tp-neal/stm32-self-balancing-robot/models/2-Wheel+Self-balancing+Robot.stl

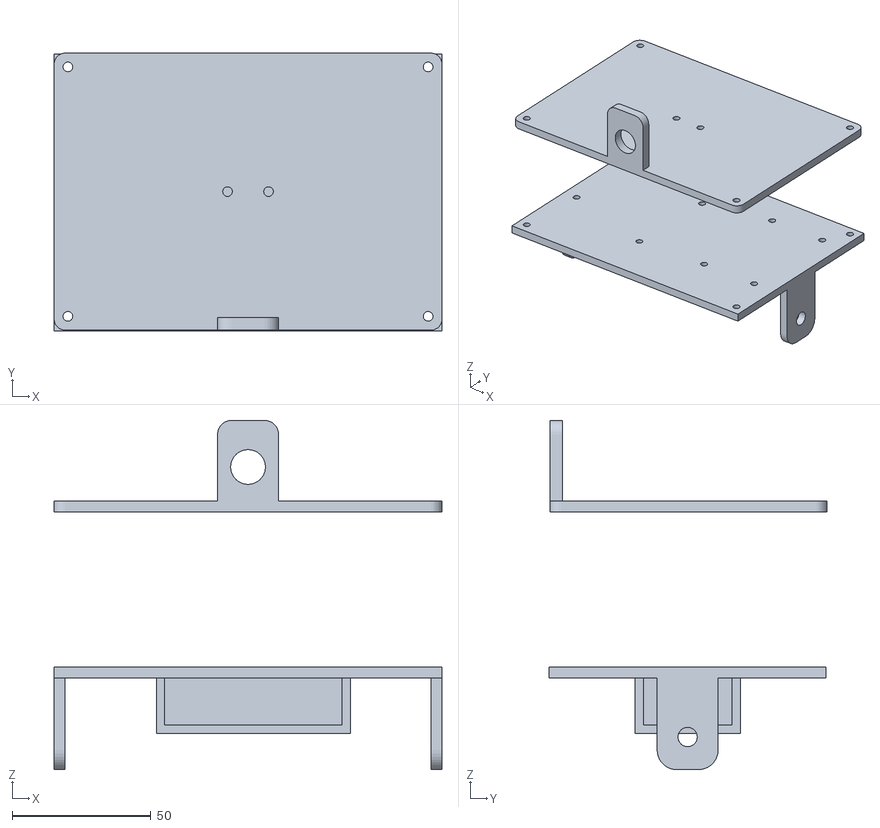
[picture p3: CAD file, 2025-08-22]
models/2-Wheel+Self-balancing+Robot.stl
140.0 x 100.3 x 126.0
