tp-neal/stm32-self-balancing-robot/Core/Src/main.c

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
/* Includes ------------------------------------------------------------------*/
#include "main.h"
#include "cmsis_os.h"

/* USER CODE BEGIN Includes */
#include <stdio.h>
#include <stdlib.h>
#include <string.h>
#include <math.h>
#include <inttypes.h>
#include "queue.h"
/* USER CODE END Includes */

/* USER CODE BEGIN PTD */
typedef struct {
	float accel_pitch;	// holds the accelerometer's derrived pitch
	float gyro_pitch;	// holds the gyroscope's integrated pitch
	float comp_pitch;	// holds the complementary filter's computed pitch
} Pitch_t;

typedef struct {
	TIM_HandleTypeDef *htim;	// pointer to the motor's timer handler struct
	uint8_t channels[2];		// holds both motor's pwm channels
} Motor_t;

typedef enum {
	COMPLETE_SUCCESS = 0,
	IMU_CONFIG_FAILED_WAKE = -100,
	IMU_CONFIG_FAILED_PWR_MGMT_2_READ = -101,
	IMU_CONFIG_FAILED_PWR_MGMT_2_WRITE = -102,
	IMU_CONFIG_FAILED_INTERRUPT_ENABLE = -103,
} Error_code_t;
/* USER CODE END PTD */

/* USER CODE BEGIN PD */
#define I2C_TRIALS 5						// number of attempts to check device readiness
#define MPU6050_Addr (0x68 << 1)			// address of the mpu6050 on the I2C line
#define MPU6050_WAKE 0x00					// mask used to wake the mpu6050 from sleep
#define PWR_MGMT_1_Addr 0x6B				// address of the first power management register of the mpu6050
#define PWR_MGMT_2_Addr 0x6C				// address of the first power management register of the mpu6050
#define INT_ENABLE_Addr 0x38				// address for imu registers that allows enabling of the interrupt pin
#define STANDBY_ACCEL_Y_AXIS (1UL << 4) 	// mask for accelerometer y-axis standby mode bit
#define STANDBY_GYRO_X_AXIS (1UL << 2) 		// mask for gyroscope x-axis standby mode bit
#define STANDBY_GYRO_Z_AXIS (1UL << 0)  	// mask for gyroscope z-axis standby mode bit
#define MPU6050_DATA_READY_Enable 0x01		// ???
#define ACCEL_XOUT_H_Addr 0x3B				// address of the high byte for accelerometer x-axis output
#define ACCEL_XOUT_L_Addr 0x3C				// address of the low byte for accelerometer x-axis output
#define ACCEL_ZOUT_H_Addr 0x3F				// address of the high byte for accelerometer z-axis output
#define ACCEL_ZOUT_L_Addr 0x40				// address of the low byte for accelerometer z-axis output
#define GYRO_YOUT_H_Addr 0x45				// address of the high byte for gyroscope y-axis output
#define GYRO_YOUT_L_Addr 0x46				// address of the high byte for gyroscope y-axis output
#define ACCEL_SENSITIVITY 16384				// sensitivity value used to convert raw IMU data into units
#define GYRO_SENSITIVITY 131				// sensitivity value used to convert raw IMU data into units
#define COMP_FILTER_COEFF 0.99				// coefficient the complementary filter uses to weight its measurment

#define IMU_CALIBRATION_PRE_MSG_DELAY 1000	// delay before calibration message allowing user to get robot into place
#define IMU_CALIBRATION_POST_MSG_DELAY 1000	// delay after calibration message allowing user to read the calibration value

#define PRINT_IMU_CONFIG_ERRORS 1			// prints IMU configuration errors when set to 1
#define PRINT_IMU_CALIBRATION_ERRORS 1		// prints IMU calibration errors when set to 1
#define PRINT_I2C_ERRORS 0					// prints I2C communication info when set to 1
#define PRINT_PID_ERROR 0					// prints PID errors when set to 1

#define PRINT_COMPUTED_PITCHES 0			// prints computed complementary pitches when set to 1
#define IMU_CONFIG_NUM_SAMPLES 100			// number of samples that are to be used to zero out accelerometer pitch
#define NUM_IMU_READ_ATTEMPTS_PER_READ 1	// when our attempt to read from the imu fails, this is the amount of retries before giving up

#define AUTO_RELOAD_REGISTER 4000			// auto reload register value for the pwm channels
#define TICKS_PER_SECOND 1000				// number of clock ticks per second

#define I2C_TIMEOUT_MS 10 					// milliseconds to wait per attempt
#define UART_TIMEOUT_MS HAL_MAX_DELAY 		// milliseconds to wait per uart transmit

#define UART_INTERRUPT_CHAR_SENDBACK_TIMEOUT 10

#define COEFFICIENT_PERCISION 3

#define D_OUT_SCALER 100
/* USER CODE END PD */

/* USER CODE BEGIN PM */
#define FATAL_ERROR(code) do { \
    g_error_file = __FILE__; \
    g_error_line = __LINE__; \
    g_error_code = (code);   \
    Error_Handler();         \
} while(0)
/* USER CODE END PM */

I2C_HandleTypeDef hi2c1;

TIM_HandleTypeDef htim2;
TIM_HandleTypeDef htim3;

UART_HandleTypeDef huart2;

/* Definitions for defaultTask */
osThreadId_t defaultTaskHandle;
const osThreadAttr_t defaultTask_attributes = { .name = "defaultTask", .stack_size = 128 * 4,
		.priority = (osPriority_t) osPriorityNormal, };
/* Definitions for imuReadTask */
osThreadId_t imuReadTaskHandle;
const osThreadAttr_t imuReadTask_attributes = { .name = "imuReadTask", .stack_size = 512 * 4,
		.priority = (osPriority_t) osPriorityHigh, };
/* Definitions for balanceTask */
osThreadId_t balanceTaskHandle;
const osThreadAttr_t balanceTask_attributes = { .name = "balanceTask", .stack_size = 512 * 4,
		.priority = (osPriority_t) osPriorityHigh, };
/* Definitions for coefficientPoll */
osThreadId_t coefficientPollHandle;
const osThreadAttr_t coefficientPoll_attributes = { .name = "coefficientPoll",
		.stack_size = 512 * 4, .priority = (osPriority_t) osPriorityNormal, };
/* Definitions for uartRxQueue */
osMessageQueueId_t uartRxQueueHandle;
const osMessageQueueAttr_t uartRxQueue_attributes = { .name = "uartRxQueue" };
/* Definitions for imuDataMutex */
osMutexId_t imuDataMutexHandle;
const osMutexAttr_t imuDataMutex_attributes = { .name = "imuDataMutex" };
/* Definitions for imuDataReadySem */
osSemaphoreId_t imuDataReadySemHandle;
const osSemaphoreAttr_t imuDataReadySem_attributes = { .name = "imuDataReadySem" };
/* Definitions for uartDataReady */
osSemaphoreId_t uartDataReadyHandle;
const osSemaphoreAttr_t uartDataReady_attributes = { .name = "uartDataReady" };
/* USER CODE BEGIN PV */
volatile const char *g_error_file = NULL;
volatile int g_error_line = 0;
volatile int g_error_code = 0;

volatile Pitch_t pitches = { .accel_pitch = 0.0, .gyro_pitch = 0.0, .comp_pitch = 0.0 };
float initial_accel_pitch_offset_deg = 0.0f;

Motor_t left_motor;
Motor_t right_motor;

uint8_t uart_recieved_byte;
uint16_t uart_recieved_byte_size = sizeof(uart_recieved_byte);

uint8_t uart_rx_buffer_index = 0;
char uart_rx_buffer[6]; // [0] type | [1:3] value | [4] carriage return | [5] null-terminator
uint16_t uart_rx_buffer_size = sizeof(uart_rx_buffer) / sizeof(uart_rx_buffer[0]);

volatile float kp = 0.20;
volatile float ki = 1.00;
volatile float kd = 0.30;
/* USER CODE END PV */

void SystemClock_Config(void);
static void MX_GPIO_Init(void);
static void MX_USART2_UART_Init(void);
static void MX_I2C1_Init(void);
static void MX_TIM2_Init(void);
static void MX_TIM3_Init(void);
void StartDefaultTask(void *argument);
void startIMUReadTask(void *argument);
void selfBalanceTask(void *argument);
void coefficientPollingTask(void *argument);

/* USER CODE BEGIN PFP */
// --- IMU Functions ---
static void configure_imu_power(void);
static void calibrate_imu(void);
static void process_imu_data(const uint8_t *data_buffer, Pitch_t *pitch_buffer, float dt);
static void update_global_imu_data(Pitch_t *pitch_buffer);
static void print_i2c_read_error(void);

// --- Motor Driver Functions ---
static void start_pwm_channels(void);
static void set_motor_duty_cycle(Motor_t *motor, float speed_control);

// --- Helper Functions ---
static void uart_print(char *buffer);
static void resetI2C(void);
char* HAL_StatusToString(HAL_StatusTypeDef status);
char* HAL_I2C_ErrorToString(I2C_HandleTypeDef* i2c_handle);
/* USER CODE END PFP */

/**
 * @brief  The application entry point.
 * @retval int
 */
int main(void) {

	/* MCU Configuration--------------------------------------------------------*/

	/* Reset of all peripherals, Initializes the Flash interface and the Systick. */
	HAL_Init();

	/* Configure the system clock */
	SystemClock_Config();

	/* Initialize all configured peripherals */
	MX_GPIO_Init();
	MX_USART2_UART_Init();
	MX_I2C1_Init();
	MX_TIM2_Init();
	MX_TIM3_Init();
	/* USER CODE BEGIN 2 */
	char nl[] = "\r\n";
	uart_print(nl); // quick newline print to seperate console logs

	// Configure the Motors
	left_motor.htim = &htim2;
	left_motor.channels[0] = TIM_CHANNEL_1;
	left_motor.channels[1] = TIM_CHANNEL_2;
	right_motor.htim = &htim3;
	right_motor.channels[0] = TIM_CHANNEL_3;
	right_motor.channels[1] = TIM_CHANNEL_4;

	HAL_GPIO_WritePin(DRV8833_SLEEP_GPIO_Port, DRV8833_SLEEP_Pin, GPIO_PIN_RESET); // make sure motor is in low power (steadystate)
	start_pwm_channels();
	HAL_GPIO_WritePin(DRV8833_SLEEP_GPIO_Port, DRV8833_SLEEP_Pin, GPIO_PIN_SET); // take motor driver out of low power

	// Prepare imu
	configure_imu_power(); // configure the imu for i2c communication
	calibrate_imu(); // zero out the accelerometer's pitch calculation

	// Start listening for user's input to tweak variables during runtime
	if (HAL_UART_Receive_IT(&huart2, &uart_recieved_byte, 1) != HAL_OK) {
		char error_buffer[] = "[WARNING]: UART interrupt service is not functioning\r\n";
		uart_print(error_buffer);
	}
	/* USER CODE END 2 */

	/* Init scheduler */
	osKernelInitialize();
	/* Create the mutex(es) */
	/* creation of imuDataMutex */
	imuDataMutexHandle = osMutexNew(&imuDataMutex_attributes);

	/* USER CODE BEGIN RTOS_MUTEX */
	/* add mutexes, ... */
	/* USER CODE END RTOS_MUTEX */

	/* Create the semaphores(s) */
	/* creation of imuDataReadySem */
	imuDataReadySemHandle = osSemaphoreNew(1, 0, &imuDataReadySem_attributes);

	/* creation of uartDataReady */
	uartDataReadyHandle = osSemaphoreNew(1, 0, &uartDataReady_attributes);

	/* USER CODE BEGIN RTOS_SEMAPHORES */
	/* add semaphores, ... */
	/* USER CODE END RTOS_SEMAPHORES */

	/* USER CODE BEGIN RTOS_TIMERS */
	/* start timers, add new ones, ... */
	/* USER CODE END RTOS_TIMERS */

	/* Create the queue(s) */
	/* creation of uartRxQueue */
	uartRxQueueHandle = osMessageQueueNew(8, sizeof(uint8_t), &uartRxQueue_attributes);

	/* USER CODE BEGIN RTOS_QUEUES */
	/* add queues, ... */
	/* USER CODE END RTOS_QUEUES */

	/* Create the thread(s) */
	/* creation of defaultTask */
	defaultTaskHandle = osThreadNew(StartDefaultTask, NULL, &defaultTask_attributes);

	/* creation of imuReadTask */
	imuReadTaskHandle = osThreadNew(startIMUReadTask, NULL, &imuReadTask_attributes);

	/* creation of balanceTask */
	balanceTaskHandle = osThreadNew(selfBalanceTask, NULL, &balanceTask_attributes);

	/* creation of coefficientPoll */
	coefficientPollHandle = osThreadNew(coefficientPollingTask, NULL, &coefficientPoll_attributes);

	/* USER CODE BEGIN RTOS_THREADS */
	/* add threads, ... */
	/* USER CODE END RTOS_THREADS */

	/* USER CODE BEGIN RTOS_EVENTS */
	/* add events, ... */
	/* USER CODE END RTOS_EVENTS */

	/* Start scheduler */
	osKernelStart();

	/* We should never get here as control is now taken by the scheduler */

	/* Infinite loop */
	/* USER CODE BEGIN WHILE */
	while (1) {
		/* USER CODE END WHILE */

		/* USER CODE BEGIN 3 */
	}
	/* USER CODE END 3 */
}

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
/* USER CODE BEGIN 4 */
/*===============================================================================================*/
// IMU Functions
/*===============================================================================================*/

/**
 * @brief Prepares I2C communication and configures the MPU6050 to begin comms.
 */
static void configure_imu_power(void) {
	// Wait for the IMU to be ready
	while (HAL_I2C_IsDeviceReady(&hi2c1, MPU6050_Addr, I2C_TRIALS, I2C_TIMEOUT_MS) != HAL_OK)
		;
	// we cannot proceed until this device is ready

	uint8_t data_byte;

	// Wake up the MPU6050 from sleep mode
	data_byte = MPU6050_WAKE; // we will clear the sleep bit
	while (HAL_I2C_Mem_Write(&hi2c1, MPU6050_Addr, PWR_MGMT_1_Addr, I2C_MEMADD_SIZE_8BIT,
			&data_byte, 1, I2C_TIMEOUT_MS) != HAL_OK) {
		FATAL_ERROR(IMU_CONFIG_FAILED_WAKE);
	}

	// Wait a few ms for the device to stabilize after power changes
	HAL_Delay(10);

	// Set unused IMU peripherals into standby mode
	// Read the current register value to not overwrite other settings
	while (HAL_I2C_Mem_Read(&hi2c1, MPU6050_Addr, PWR_MGMT_2_Addr, I2C_MEMADD_SIZE_8BIT, &data_byte,
			1, I2C_TIMEOUT_MS) != HAL_OK) {
		FATAL_ERROR(IMU_CONFIG_FAILED_PWR_MGMT_2_READ);
	}

	data_byte |= (STANDBY_ACCEL_Y_AXIS | STANDBY_GYRO_X_AXIS | STANDBY_GYRO_Z_AXIS);

	// Write the modified value back to the register
	while (HAL_I2C_Mem_Write(&hi2c1, MPU6050_Addr, PWR_MGMT_2_Addr, I2C_MEMADD_SIZE_8BIT,
			&data_byte, 1,
			I2C_TIMEOUT_MS) != HAL_OK) {
		FATAL_ERROR(IMU_CONFIG_FAILED_PWR_MGMT_2_WRITE);
	}

	// Enable the Data Ready Interrupt on the MPU6050
	data_byte = MPU6050_DATA_READY_Enable; // sets the DATA_RDY_EN bit
	while (HAL_I2C_Mem_Write(&hi2c1, MPU6050_Addr, INT_ENABLE_Addr, I2C_MEMADD_SIZE_8BIT,
			&data_byte, 1,
			I2C_TIMEOUT_MS) != HAL_OK) {
		FATAL_ERROR(IMU_CONFIG_FAILED_INTERRUPT_ENABLE);
	}
}

/**
 * @brief Establishes a baseline for the IMU to disregard initial pitch.
 */
static void calibrate_imu(void) {
	uint8_t rx_buffer[14];
	float sum_accel_x_g_force = 0;
	float sum_accel_z_g_force = 0;

	char calibration_warning[] = "Calibrating... Keep robot Level!\r\n";
	uart_print(calibration_warning);
	HAL_Delay(IMU_CALIBRATION_PRE_MSG_DELAY);

	// Make sure MPU is ready before starting
	while (HAL_I2C_IsDeviceReady(&hi2c1, MPU6050_Addr, I2C_TRIALS, I2C_TIMEOUT_MS) != HAL_OK) {
		// wait for device to be ready
	}

	// Perform a number of reads to get a baseline measurment for zeroing out the accelerometer pitch
	HAL_StatusTypeDef status;
	int attempts;
	for (int i = 0; i < IMU_CONFIG_NUM_SAMPLES; i++) {
		// We need to make sure we get a valid read for every sample to ensure our zeroing is accurate
		attempts = 0;
		while ((status = HAL_I2C_Mem_Read(&hi2c1, MPU6050_Addr, ACCEL_XOUT_H_Addr, I2C_MEMADD_SIZE_8BIT,
				rx_buffer, 14, I2C_TIMEOUT_MS)) != HAL_OK && attempts < NUM_IMU_READ_ATTEMPTS_PER_READ) {
			// We will attempt to read the IMU, and if it doesnt give us a valid read after x, attemps reset the I2C bus and try again
			if (PRINT_IMU_CALIBRATION_ERRORS) {
				char error_buffer[128];
				sprintf(error_buffer, "Failed to read from IMU during calibration [%s]\r\n", HAL_StatusToString(status));
				uart_print(error_buffer);

				if (status == HAL_ERROR) {
					// If the status is an I2C error, print info
					uart_print(HAL_I2C_ErrorToString(&hi2c1));
				}
			}

			attempts++;
			if (attempts >= NUM_IMU_READ_ATTEMPTS_PER_READ) {
				resetI2C();
				attempts = 0;
			}

		}

		// Since read was successful, decode it
		int16_t raw_accel_x = (int16_t) (rx_buffer[0] << 8 | rx_buffer[1]);
		int16_t raw_accel_z = (int16_t) (rx_buffer[4] << 8 | rx_buffer[5]);

		float adjusted_accel_x = ((float) raw_accel_x / ACCEL_SENSITIVITY);
		float adjusted_accel_z = ((float) raw_accel_z / ACCEL_SENSITIVITY);

		sum_accel_x_g_force += adjusted_accel_x;
		sum_accel_z_g_force += adjusted_accel_z;
	}

	// Calculate the average offset
	float avg_accel_x_g_force = sum_accel_x_g_force / IMU_CONFIG_NUM_SAMPLES;
	float avg_accel_z_g_force = sum_accel_z_g_force / IMU_CONFIG_NUM_SAMPLES;

	// Calculate the initial angle from the averages and store it
	initial_accel_pitch_offset_deg = atan2(avg_accel_x_g_force, avg_accel_z_g_force) * 180.0 / M_PI;

	char calibration_complete[128];
	sprintf(calibration_complete, "Calibration complete! Offset Angle: %f\r\n",
			initial_accel_pitch_offset_deg);
	uart_print(calibration_complete);

	HAL_Delay(IMU_CALIBRATION_POST_MSG_DELAY);
}

/**
 * @brief Converts raw IMU data into the process pitch values for the accelerometer, gyroscope, and complementary filter
 * @param const uint8_t* data_buffer - Buffer that contains the raw data read from the I2C channel
 * @param Pitch_t* pitch_buffer - Buffer to store the computed pitches in for return
 * @param float dt - Change in time between the last data read and the current
 */
static void process_imu_data(const uint8_t *data_buffer, Pitch_t *pitch_buffer, float dt) {
	// Combine high and low bytes
	int16_t raw_accel_x = (int16_t) (data_buffer[0] << 8 | data_buffer[1]);
	int16_t raw_accel_z = (int16_t) (data_buffer[4] << 8 | data_buffer[5]);
	int16_t raw_gyro_y = (int16_t) (data_buffer[10] << 8 | data_buffer[11]);

	float accel_x = ((float) raw_accel_x / ACCEL_SENSITIVITY);
	float accel_z = ((float) raw_accel_z / ACCEL_SENSITIVITY);
	float gyro_y = ((float) raw_gyro_y / GYRO_SENSITIVITY);

	float absolute_accel_pitch_deg = atan2(accel_x, accel_z) * 180.0 / M_PI;
	float relative_accel_pitch_deg = absolute_accel_pitch_deg - initial_accel_pitch_offset_deg;

	pitch_buffer->accel_pitch = relative_accel_pitch_deg;
	pitch_buffer->gyro_pitch = (gyro_y * dt);
	osMutexAcquire(imuDataMutexHandle, osWaitForever);
	pitch_buffer->comp_pitch = COMP_FILTER_COEFF * (pitches.comp_pitch - pitch_buffer->gyro_pitch)
			+ (1.0 - COMP_FILTER_COEFF) * pitch_buffer->accel_pitch;
	osMutexRelease(imuDataMutexHandle);
}

/**
 * @brief Updates the global references of the objects transform and pitches
 * @param Pitch_t* pitch_buffer - Buffer that contains the computed pitches to write to the gloabal reference
 */
static void update_global_imu_data(Pitch_t *pitch_buffer) {
	osMutexAcquire(imuDataMutexHandle, osWaitForever);

	// Update estimated pitch information
	pitches.accel_pitch = pitch_buffer->accel_pitch;
	pitches.gyro_pitch -= pitch_buffer->gyro_pitch;
	pitches.comp_pitch = pitch_buffer->comp_pitch;
	osMutexRelease(imuDataMutexHandle);

	if (PRINT_COMPUTED_PITCHES) {
		char uartBuffer[128];
		sprintf(uartBuffer, "accel-pitch: %f\tgyro-pitch: %f\tcomp-pitch: %f\r\n",
				pitches.accel_pitch, pitches.gyro_pitch, pitches.comp_pitch);
		uart_print(uartBuffer);
	}
}

/**
 * @brief Prints a descriptive message to UART based on the I2C error code
 */
static void print_i2c_read_error(void) {
	char errorBuffer[128];
	uint32_t i2c_error = HAL_I2C_GetError(&hi2c1);

	if (i2c_error & HAL_I2C_ERROR_BERR) {
		sprintf(errorBuffer,
				"MPU6050 Read Error: Bus Error (BERR). Check wiring/signal integrity.\r\n");
	} else if (i2c_error & HAL_I2C_ERROR_ARLO) {
		sprintf(errorBuffer,
				"MPU6050 Read Error: Arbitration Lost (ARLO). Check for noise or other masters.\r\n");
	} else if (i2c_error & HAL_I2C_ERROR_AF) {
		sprintf(errorBuffer,
				"MPU6050 Read Error: Acknowledge Failure (AF/NACK). Sensor may be busy or disconnected.\r\n");
	} else if (i2c_error & HAL_I2C_ERROR_OVR) {
		sprintf(errorBuffer, "MPU6050 Read Error: Overrun/Underrun (OVR).\r\n");
	} else if (i2c_error & HAL_I2C_ERROR_TIMEOUT) {
		sprintf(errorBuffer, "MPU6050 Read Error: Timeout occurred. Check bus activity.\r\n");
	} else if (i2c_error & HAL_I2C_ERROR_DMA) {
		sprintf(errorBuffer, "MPU6050 Read Error: DMA transfer error.\r\n");
	} else {
		sprintf(errorBuffer, "MPU6050 Read Error: Unknown I2C Error. Code: 0x%lX\r\n", i2c_error);
	}
	uart_print(errorBuffer);
}

/*===============================================================================================*/
// Motor Driver Functions
/*===============================================================================================*/

/**
 * @brief Begins the timer pwm channels and puts them in a stopped position
 */
static void start_pwm_channels(void) {
	// Begin the PWM
	HAL_TIM_PWM_Start(&htim2, TIM_CHANNEL_1);
	HAL_TIM_PWM_Start(&htim2, TIM_CHANNEL_2);
	HAL_TIM_PWM_Start(&htim3, TIM_CHANNEL_3);
	HAL_TIM_PWM_Start(&htim3, TIM_CHANNEL_4);

	// Default motors with no movement
	__HAL_TIM_SET_COMPARE(&htim2, TIM_CHANNEL_1, 0);
	__HAL_TIM_SET_COMPARE(&htim2, TIM_CHANNEL_2, 0);
	__HAL_TIM_SET_COMPARE(&htim3, TIM_CHANNEL_3, 0);
	__HAL_TIM_SET_COMPARE(&htim3, TIM_CHANNEL_4, 0);
}

/**
 * @brief Sets a motor's speed and direction.
 * @param Motor_t motor : Motor structure to be driven.
 * @param uint8_t drive_channel : Indicates which channel to use PWM on -- channel 1, 2, or 0 if neither needs pwm.
 * @param float duty_coeff : The fraction of power to drive the motor. *TODO* figure out margin of accuracy
 */
static void set_motor_duty_cycle(Motor_t *motor, float speed_control) {
	// Clamp the speed
	if (speed_control > 1.0f) {
		speed_control = 1.0f;
	}
	if (speed_control < -1.0f) {
		speed_control = -1.0f;
	}

	uint16_t crr = fabsf(AUTO_RELOAD_REGISTER * speed_control);
	// uint16_t crr = AUTO_RELOAD_REGISTER/2 + fabsf(AUTO_RELOAD_REGISTER/2 * speed_control);

	if (speed_control > 0) {
		__HAL_TIM_SET_COMPARE(motor->htim, motor->channels[0], 0);
		__HAL_TIM_SET_COMPARE(motor->htim, motor->channels[1], crr);
	} else if (speed_control < 0) {
		__HAL_TIM_SET_COMPARE(motor->htim, motor->channels[0], crr);
		__HAL_TIM_SET_COMPARE(motor->htim, motor->channels[1], 0);
	} else {
		__HAL_TIM_SET_COMPARE(motor->htim, motor->channels[0], 0);
		__HAL_TIM_SET_COMPARE(motor->htim, motor->channels[1], 0);
	}
}

/*===============================================================================================*/
// Hardware Level Interrupts
/*===============================================================================================*/

/**
 * @brief Callback function for when there is a hardware level interrupt on the ??? line
 */
void HAL_GPIO_EXTI_Callback(uint16_t GPIO_Pin) {
	// Check if the interrupt came from the IMU's interrupt pin
	if (GPIO_Pin == MPU6050_INT_Pin) {
		osSemaphoreRelease(imuDataReadySemHandle);
	}
}

/**
 * @brief Callback function when data is asyncronously detected on the UART2 line
 */
void HAL_UART_RxCpltCallback(UART_HandleTypeDef *huart) {
	if (huart->Instance != USART2)
		return;

	osMessageQueuePut(uartRxQueueHandle, &uart_recieved_byte, 0, 0);
	HAL_UART_Receive_IT(&huart2, &uart_recieved_byte, 1);
}

/*===============================================================================================*/
// Helper Functions
/*===============================================================================================*/

/**
 * @brief Prints a character buffer over the uart communication channel
 * @param char* buffer - Buffer to be transmitted over the UART line
 */
static void uart_print(char *buffer) {
	HAL_UART_Transmit(&huart2, (uint8_t*) buffer, strlen(buffer), UART_TIMEOUT_MS);
}

/**
 * @brief TODO
 */
static void resetI2C(void) {
	HAL_I2C_DeInit(&hi2c1);
	HAL_I2C_Init(&hi2c1);
	HAL_I2CEx_ConfigAnalogFilter(&hi2c1, I2C_ANALOGFILTER_ENABLE);
	HAL_I2CEx_ConfigDigitalFilter(&hi2c1, 0);
}

char* HAL_StatusToString(HAL_StatusTypeDef status) {
    switch (status) {
        case HAL_OK:
            return "HAL_OK";
        case HAL_ERROR:
            return "HAL_ERROR";
        case HAL_BUSY:
            return "HAL_BUSY";
        case HAL_TIMEOUT:
            return "HAL_TIMEOUT";
        default:
            return "UNKNOWN_STATUS";
    }
}

char* HAL_I2C_ErrorToString(I2C_HandleTypeDef* i2c_handle) {
	uint32_t error = HAL_I2C_GetError(i2c_handle);

	if (error & HAL_I2C_ERROR_BERR) {
		return "--> Specific Error: Bus Error (BERR)\r\n";
	}
	if (error & HAL_I2C_ERROR_ARLO) {
		return "--> Specific Error: Arbitration Lost (ARLO)\r\n";
	}
	if (error & HAL_I2C_ERROR_AF) {
		return "--> Specific Error: Acknowledge Failure (AF)\r\n";
	}
	if (error & HAL_I2C_ERROR_OVR) {
		return "--> Specific Error: Overrun/Underrun (OVR)\r\n";
	}
	else {
		return "--> Unknown Error: No information can be provided (N/A)\r\n";
	}
}

/*===============================================================================================*/
/* USER CODE END 4 */

/* USER CODE BEGIN Header_StartDefaultTask */
/**
 * @brief  Func tion implementing the defaultTask thread.
 * @param  argument: Not used
 * @retval None
 */
/* USER CODE END Header_StartDefaultTask */
void StartDefaultTask(void *argument) {
	/* USER CODE BEGIN 5 */
	/* Infinite loop */
	for (;;) {
		osDelay(1);
	}
	/* USER CODE END 5 */
}

/* USER CODE BEGIN Header_startIMUReadTask */
/**
 * @brief Function implementing the imuReadTask thread.
 * @param argument: Not used
 * @retval None
 */
/* USER CODE END Header_startIMUReadTask */
void startIMUReadTask(void *argument) {
	/* USER CODE BEGIN startIMUReadTask */
	uint32_t last_tick = osKernelGetTickCount(); // initialize starting tick

	/* Infinite loop */
	for (;;) {
		// Wait for interrupt pin to signal new data is available
		osSemaphoreAcquire(imuDataReadySemHandle, osWaitForever);

		// Keep track of the system tick so we can integrate gyro rotation
		uint32_t current_tick = osKernelGetTickCount();
		float dt = (float) (current_tick - last_tick) / (float) TICKS_PER_SECOND;
		last_tick = current_tick;

		// Read the accelerometer and gyroscope data into a buffer
		HAL_StatusTypeDef status = HAL_OK;
		uint8_t rx_buffer[14];
		for (uint8_t attempts = 0; attempts < NUM_IMU_READ_ATTEMPTS_PER_READ; attempts++) {
			status = HAL_I2C_Mem_Read(&hi2c1, MPU6050_Addr, ACCEL_XOUT_H_Addr, I2C_MEMADD_SIZE_8BIT,
					rx_buffer, 14, I2C_TIMEOUT_MS);
			if (status == HAL_OK)
				break;
		}

		if (status != HAL_OK) {
			// Attempt to recover the I2C bus by re-initializing it
			resetI2C();

			if (PRINT_I2C_ERRORS) {
				print_i2c_read_error();
			}
		}

		Pitch_t pitch_buffer;
		process_imu_data(rx_buffer, &pitch_buffer, dt);
		update_global_imu_data(&pitch_buffer);

		osDelay(10); // short wait between reads
	}
	/* USER CODE END startIMUReadTask */
}

/* USER CODE BEGIN Header_selfBalanceTask */
/**
 * @brief Function implementing the balanceTask thread.
 * @param argument: Not used
 * @retval None
 */
/* USER CODE END Header_selfBalanceTask */
void selfBalanceTask(void *argument) {
	/* USER CODE BEGIN selfBalanceTask */
	uint32_t last_tick = osKernelGetTickCount(); // initialize starting tick
	float integralSum = 0.0;
	float prev_error = 0.0;

	float d_out_filtered_prev = 0.0; // Buffer for previous error of d_output's low-pass filter
	float prev_bias = 0.8;

	/* Infinite loop */
	for (;;) {
		osMutexAcquire(imuDataMutexHandle, osWaitForever); // aquire imuData mutex before reading complementary pitch
		float error = 0 - pitches.comp_pitch; 				// get error (setpoint is 0 degrees)
		osMutexRelease(imuDataMutexHandle);

		// Robot is laying on its side - kill motors, reset variables, and skip cycle
		if (abs(error) >= 40) {
			set_motor_duty_cycle(&left_motor, 0);
			set_motor_duty_cycle(&right_motor, 0);
			last_tick = osKernelGetTickCount(); // reset last tick so that the integral sum doesnt get out of control
			integralSum = 0;
			continue;
		}

		// Manage time variables
		uint32_t current_tick = osKernelGetTickCount(); // initialize starting tick
		float dt = (float) (current_tick - last_tick) / (float) TICKS_PER_SECOND;
		last_tick = current_tick;

		// Calculate p-error
		float p_out = kp * (error);

		// Calculate i-error
		// *** IMPORTANT : Might need to clamp the integral sum to prevent huge corrections when first placing robot down ***
		integralSum += error * dt;
		float i_out = ki * (integralSum);

		// Calculate d-error
		float d_out = 0.0f;
		if (dt > 0) { // protect from divide-by-zero error
			d_out = kd * ((error - prev_error) / dt) / D_OUT_SCALER;
		}
//		float d_out_filtered = (prev_bias * d_out_filtered_prev) + ((1 - prev_bias) * d_out);
//		d_out_filtered_prev = d_out_filtered;

		// Final calculation
		float output = p_out + i_out + d_out;

		prev_error = error;

		set_motor_duty_cycle(&left_motor, output);
		set_motor_duty_cycle(&right_motor, output);

		osDelay(10);
	}
	/* USER CODE END selfBalanceTask */
}

/* USER CODE BEGIN Header_coefficientPollingTask */
/**
 * @brief Function implementing the coefficientPoll thread.
 * @param argument: Not used
 * @retval None
 */
/* USER CODE END Header_coefficientPollingTask */
void coefficientPollingTask(void *argument) {
	/* USER CODE BEGIN coefficientPollingTask */
	osMessageQueueReset(uartRxQueueHandle);

	/* Infinite loop */
	for (;;) {
		char queue_byte;
		osStatus_t status = osMessageQueueGet(uartRxQueueHandle, &queue_byte, NULL, osWaitForever);

		// Echo the character back to the terminal
		HAL_UART_Transmit(&huart2, (uint8_t*) &queue_byte, 1, 10);

		if (status == osOK) {
			// This logic now uses the correct global buffer that the ISR writes to
			uart_rx_buffer[uart_rx_buffer_index++] = queue_byte;

			if (queue_byte == '\r') { // Use carriage return as the submission character
				uart_rx_buffer[uart_rx_buffer_index - 1] = '\0'; // Null-terminate the string

				char cmd_type = uart_rx_buffer[0];
				char cmd_value_buffer[4];
				int cmd_value_buffer_size = sizeof(cmd_value_buffer) / sizeof(cmd_value_buffer[0]);
				strncpy(cmd_value_buffer, &uart_rx_buffer[1], COEFFICIENT_PERCISION);
				cmd_value_buffer[cmd_value_buffer_size - 1] = '\0';

				// Reset buffer for next command
				memset(uart_rx_buffer, 0, uart_rx_buffer_size);
				uart_rx_buffer_index = 0;

				int cmd_value = atoi(cmd_value_buffer);
				if (cmd_value < 0)
					cmd_value = 0;
				float cmd_value_f = ((float) cmd_value / 100.0f);

				char print_buffer[64];
				switch (cmd_type) {
				case 'p':
				case 'P':
					kp = cmd_value_f;
					sprintf(print_buffer, "\r\nSet Proportional (kp) to 0.%03d\r\n", cmd_value);
					uart_print(print_buffer);
					break;
				case 'i':
				case 'I':
					ki = cmd_value_f;
					sprintf(print_buffer, "\r\nSet Integral (ki) to 0.%03d\r\n", cmd_value);
					uart_print(print_buffer);
					break;
				case 'd':
				case 'D':
					kd = cmd_value_f;
					sprintf(print_buffer, "\r\nSet Derivative (kd) to 0.%03d\r\n", cmd_value);
					uart_print(print_buffer);
					break;
				default:
					uart_print("\r\nInvalid command. Use 'p', 'i', or 'd'.\r\n");
					break;
				}
			} else if (uart_rx_buffer_index >= uart_rx_buffer_size - 1) {
				// Buffer is full but no carriage return, reset to prevent overflow
				uart_print("\r\nBuffer full, clearing. Please re-enter command.\r\n");
				memset(uart_rx_buffer, 0, uart_rx_buffer_size);
				uart_rx_buffer_index = 0;
			}
		}
		osDelay(1);
	}
	/* USER CODE END coefficientPollingTask */
}

/**
 * @brief  Period elapsed callback in non blocking mode
 * @note   This function is called  when TIM1 interrupt took place, inside
 * HAL_TIM_IRQHandler(). It makes a direct call to HAL_IncTick() to increment
 * a global variable "uwTick" used as application time base.
 * @param  htim : TIM handle
 * @retval None
 */
void HAL_TIM_PeriodElapsedCallback(TIM_HandleTypeDef *htim) {
	if (htim->Instance == TIM1) {
		HAL_IncTick();
	}
}

/**
 * @brief  This function is executed in case of error occurrence.
 * @retval None
 */
void Error_Handler(void) {
	/* USER CODE BEGIN Error_Handler_Debug */
	char error_buffer[256];
	sprintf(error_buffer, "[FATAL ERROR]: Code %d at %s:%d", g_error_code, g_error_file,
			g_error_line);
	__disable_irq();
	while (1) {
	}
	/* USER CODE END Error_Handler_Debug */
}

#ifdef  USE_FULL_ASSERT
/**
  * @brief  Reports the name of the source file and the source line number
  *         where the assert_param error has occurred.
  * @param  file: pointer to the source file name
  * @param  line: assert_param error line source number
  * @retval None
  */
void assert_failed(uint8_t *file, uint32_t line)
{
  /* USER CODE BEGIN 6 */
  /* User can add his own implementation to report the file name and line
     number, ex: printf("Wrong parameters value: file %s on line %d\r\n", file,
     line) */
  /* USER CODE END 6 */
}
#endif /* USE_FULL_ASSERT */
