tp-neal/stm32-self-balancing-robot/stm32-self-balancing-robot.ioc

Mcu.UserName=STM32L476RGTx
PA0.Signal=S_TIM2_CH1
PA1.Signal=S_TIM2_CH2
PA2.GPIO_Label=USART_TX
PA2.Signal=USART2_TX
PA3.GPIO_Label=USART_RX
PA3.Signal=USART2_RX
PA5.GPIO_Label=LD2 [green Led]
PA5.Signal=GPIO_Output
PB0.Signal=S_TIM3_CH3
PB1.Signal=S_TIM3_CH4
PB7.Signal=I2C1_SDA
PB8.Signal=I2C1_SCL
PC10.GPIO_Label=MPU6050_INT
PC10.Signal=GPXTI10
PC13.GPIO_Label=B1 [Blue PushButton]
PC13.Signal=GPXTI13
