tp-neal/stm32-self-balancing-robot/Core/Inc/main.h

#define B1_Pin GPIO_PIN_13
#define B1_GPIO_Port GPIOC
#define B1_EXTI_IRQn EXTI15_10_IRQn
#define DRV8833_SLEEP_Pin GPIO_PIN_2
#define DRV8833_SLEEP_GPIO_Port GPIOC
#define USART_TX_Pin GPIO_PIN_2
#define USART_TX_GPIO_Port GPIOA
#define USART_RX_Pin GPIO_PIN_3
#define USART_RX_GPIO_Port GPIOA
#define LD2_Pin GPIO_PIN_5
#define LD2_GPIO_Port GPIOA
#define TMS_Pin GPIO_PIN_13
#define TMS_GPIO_Port GPIOA
#define TCK_Pin GPIO_PIN_14
#define TCK_GPIO_Port GPIOA
#define MPU6050_INT_Pin GPIO_PIN_10
#define MPU6050_INT_GPIO_Port GPIOC
#define MPU6050_INT_EXTI_IRQn EXTI15_10_IRQn
#define SWO_Pin GPIO_PIN_3
#define SWO_GPIO_Port GPIOB
