tp-neal/stm32-self-balancing-robot/(commit log)

2025-07-21 Added togglable prints for error messages, and improved function formatting.
    [main.c, main.h, self-balancing-robot.ioc]
2025-08-19 Added uart polling for PID coefficients for real time coefficient tweaking. Set PID control loop coefficients to stable values that reasonably balance the bot.
2025-08-22 Tweaked PID loop coefficients, and updated README
2025-08-22 Filled in missing parts and spellchecked the README
    [2-Wheel+Self-balancing+Robot.stl]
